dl2fw/Powermeter/images/Anschluss Display.jpg

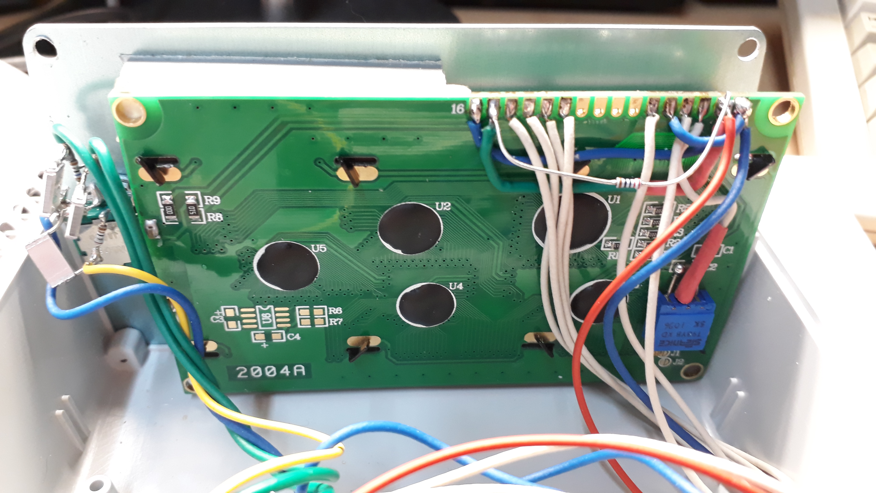
images/Anschluss Display.jpg
