dl2fw/Powermeter/images/Encoder2.jpg

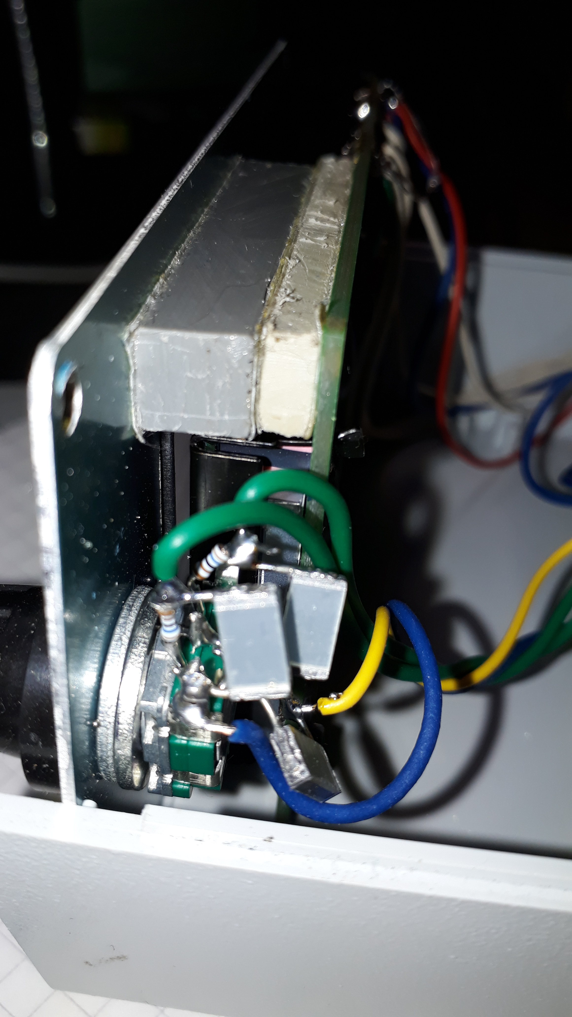
images/Encoder2.jpg
