dl2fw/Powermeter/src/Readme

Es müssen die #define Werte entsprechend angepasst werden
Die Messwerte für die Linearisierung beziehen sich auf -70dBm --> 1023
