dl2fw/Powermeter/images/Anschluss Analog u Power.jpg

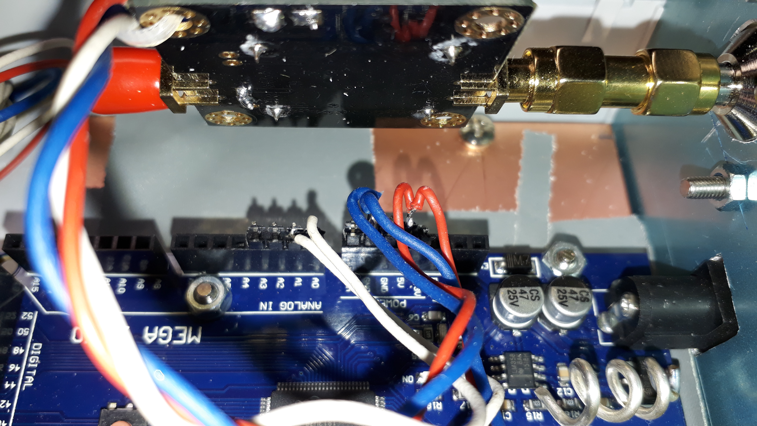
images/Anschluss Analog u Power.jpg
