dl2fw/Powermeter/images/Anschluss Display 2.jpg

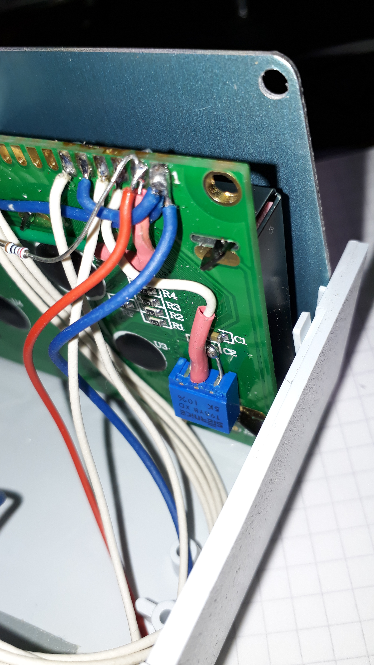
images/Anschluss Display 2.jpg
