dl2fw/Powermeter/images/Anschluss Interrupts.jpg

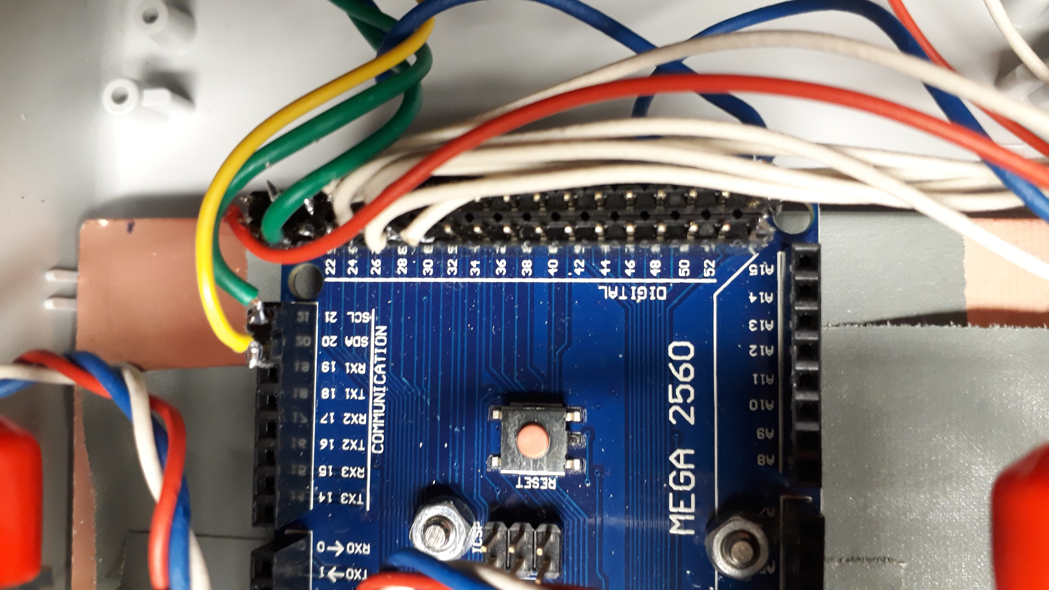
images/Anschluss Interrupts.jpg
