dl2fw/Powermeter/images/Encoder1.jpg

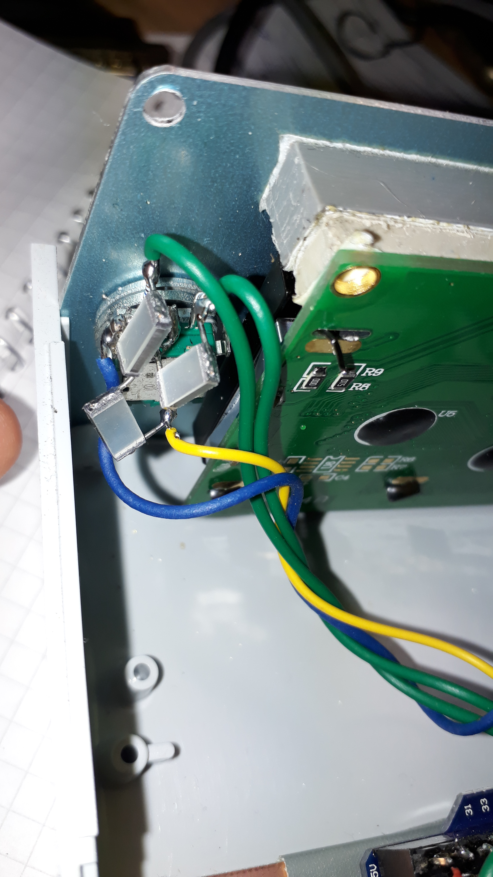
images/Encoder1.jpg
