dl2fw/Powermeter/images/Front1.jpg

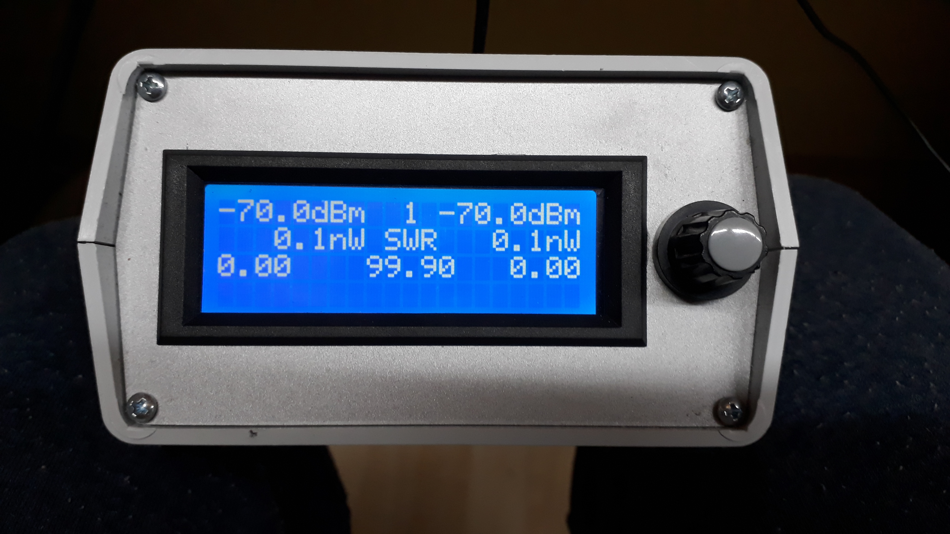
images/Front1.jpg
