dl2fw/Powermeter/images/Front2.jpg

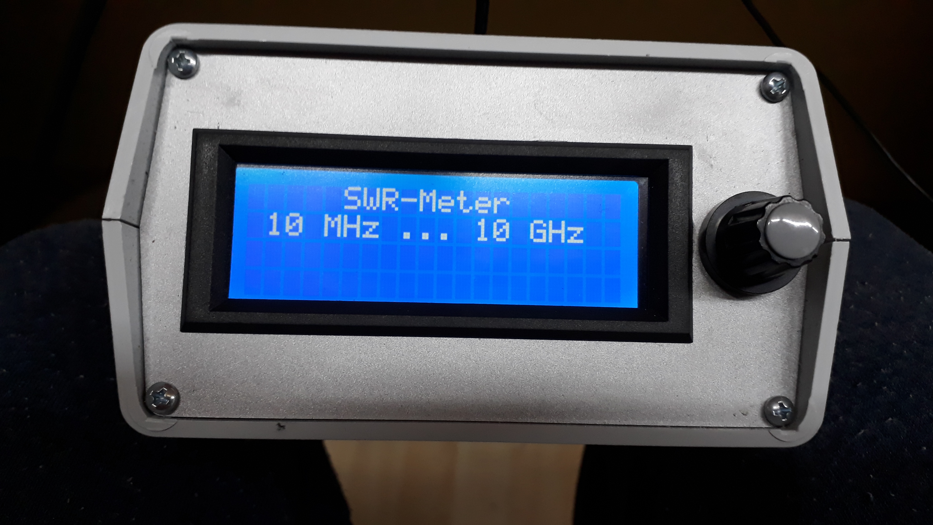
images/Front2.jpg
