dl2fw/Powermeter/images/Topview.jpg

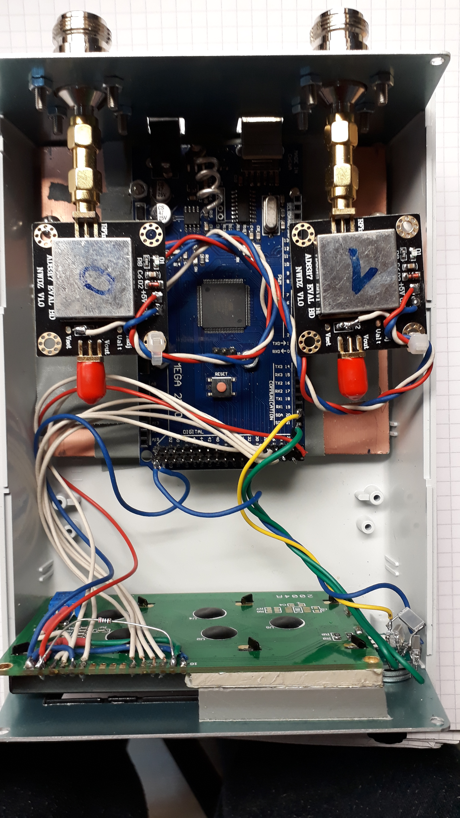
images/Topview.jpg
