dl2fw/Powermeter/schematics/Powermeter.pdf

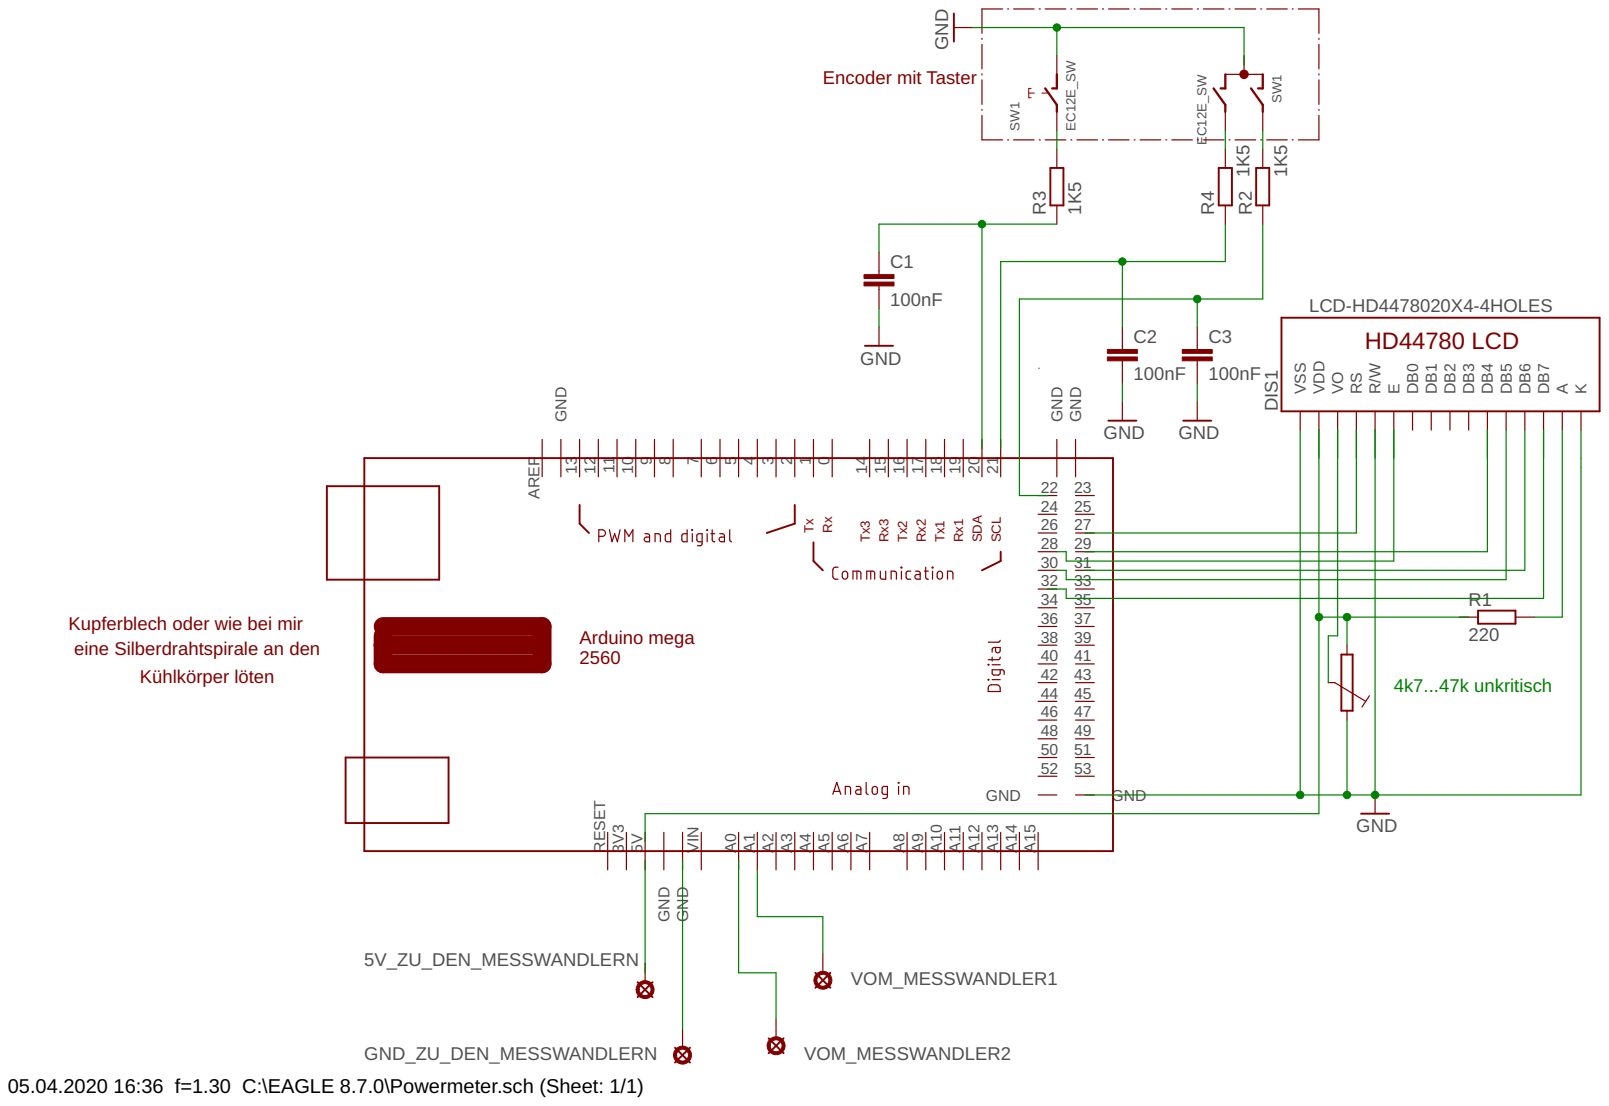
[picture p11: page 1]

Kupferblech oder wie bei mir
eine Silberdrahtspirale an den

05.04.2020 16:36 f=1.30 C:\EAGLE 8.7.0\Powermeter.sch (Sheet: 1/1)
