dl2fw/Powermeter/(commit log)

2022-01-20 Encoder schaltet zwischen Anzeigen um
2022-01-28 Defines #DL2FW und #DM6TT eingebaut, Autokorrektur funktioniert auf 0.1dB
2022-01-29 Frequenzauswahl im SWR-Display, Abbruch Kalibrierung durch Encoder
2022-01-30 Menue und Edit Einganskanaldaten
2022-01-30 Koppeldaempfung und Eingangsdaempfung werden beruechsichtigt
2022-01-31 Add files via upload
    Messwandlermodifikation zur optimalen Ausnutzung der A/D-Wandler des Arduino Mega
2022-02-02 Neue Displaydarstellung, 2 Kanal getrennt QRG und Attenuation dort konfigurierbar, ohne Speicherung
2022-02-07 Edit Koppler, noch ohne Stütztstellen und EEPROM
2022-02-12 Kopplerauswahl pro Kanal Neuer Screen, Dual mit Kopplerdaempfung Beruecksichtigung der Stuetzstellen des Kopplers bei Berechning
2022-02-20 Neue Darstellung IN1/2, umschaltbare Ausgabe, RESET im Menue (long pressed) Einige Bugs behoben - IN1/2: <Button> schaltet in den Wahlmodus der Ausgabegroesse: IN: Eingang Powermeter AT: Eingang exte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
    Long Press >3s im Hauptmenue zeigt Kalibrierungswerte an, dort ist nun ein RESET moeglich
    IRQ fuer Button auf CHNAGE umgestellt, da Loslassen des Buttons erkannt werden muss
    [SWR_METER_ohne_TFT.ino]
2022-02-20 Aenderung der QRG wird auch fuer die temporaeren Einstellungen uebernommen
2022-04-02 PA Display eingebaut. Display zeigt an: Po: Output PA gemessen am Koppler PAi: Input an der Leistungs PA (Po-Kabeldaempfung) PA0: Output der Leistungs PA Status: LIN -> linearer Betrieb (Pai < PiLin)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
